LibreSolar/mppt-2420-hpx/(threads)

Thread 1 (2020-02-26):

DAC2 not existing in STM32G431, change pin wiring

martinjaeger, 2020-02-26:
The STM32G431 only has DAC1 with two external channels, so the current DAC2 on PA6 needs to be connected to DAC1_OUT2 at PA5.

Thread 2 (2020-02-26):

Route USB power supply to SMPS input

martinjaeger, 2020-02-26:
The board power supply from USB (useful only for testing) via diode D6 should be routed to SMPS input instead of HV+, as Q9 will not let any current pass to the SMPS.

Thread 3 (2021-03-07):

R14 value should be 2.2k

xsider, 2021-03-07:
R14 should be 2.2k instead of 10k.
2.2k is the value expected by the Software.
2.2k should also be used to be save for ADC!
110k/10k -> Highvoltage over 36.3V could damage microcontroller.

martinjaeger, 2021-03-07:
Oops, yes, definitely. Thanks for posting.

Looks like I have already fixed this during transition to the MPPT 2420 HC variant. You might want to compare with that schematic in case of any doubts.

Also the internal power supply source switching circuitry in this board (page 3) didn't work properly and has been reworked. If power supply from battery side only is sufficient for you, I would just remove the high-side part around Q9 completely.

xsider, 2021-03-07:
> Also the internal power supply source switching circuitry in this board (page 3) didn't work properly and has been reworked. If power supply from battery side only is sufficient for you, I would just remove the high-side part around Q9 completely.

That's a good hint. The main cause to build the HPX was the bootstrap-capability from solar power only, which is missing in PWM_2420_LUS. I will consider to adapt the HC circuit for that, or add just a diode from solar panel, because open circuit solar voltage is below 50V.

martinjaeger, 2021-03-07:
Yeah, it's really useful if you have lithium ion batteries. But that circuit was also quite tricky. The reality was different than theoretical considerations again... the circuit in the develop branch of the HC (v0.2) is finally working as it should :)

But if your voltage is below 50V, a diode should be perfectly fine.
