LibreSolar/mppt-2420-hpx/mppt-2420-hpx.pdf

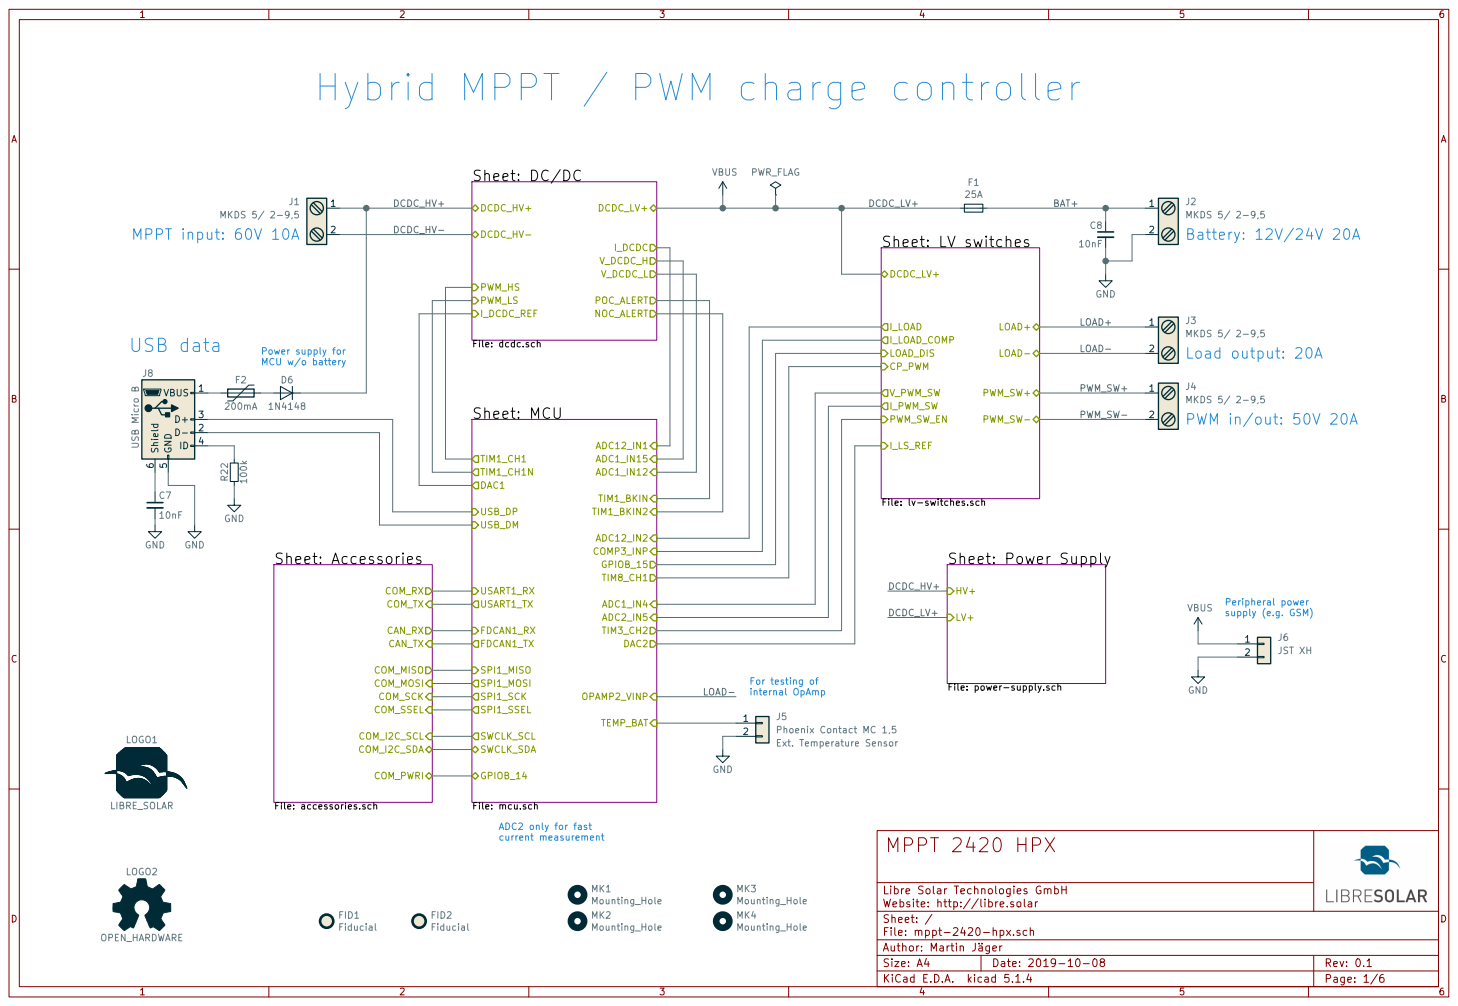
[picture p3: page 1]

Hybrid MPPT / PWM charge controller

LV+ HV+ Sheet: DC/DC

File: lv-switches.sch

File: power-supply.sch

J5Phoenix Contact MC 1,5 Ext. Temperature Sensor

ADC2 only for fast current measurement

File: mppt-2420-hpx.sch Sheet: / Libre Solar Technologies GmbH
Website: http://libre.solar

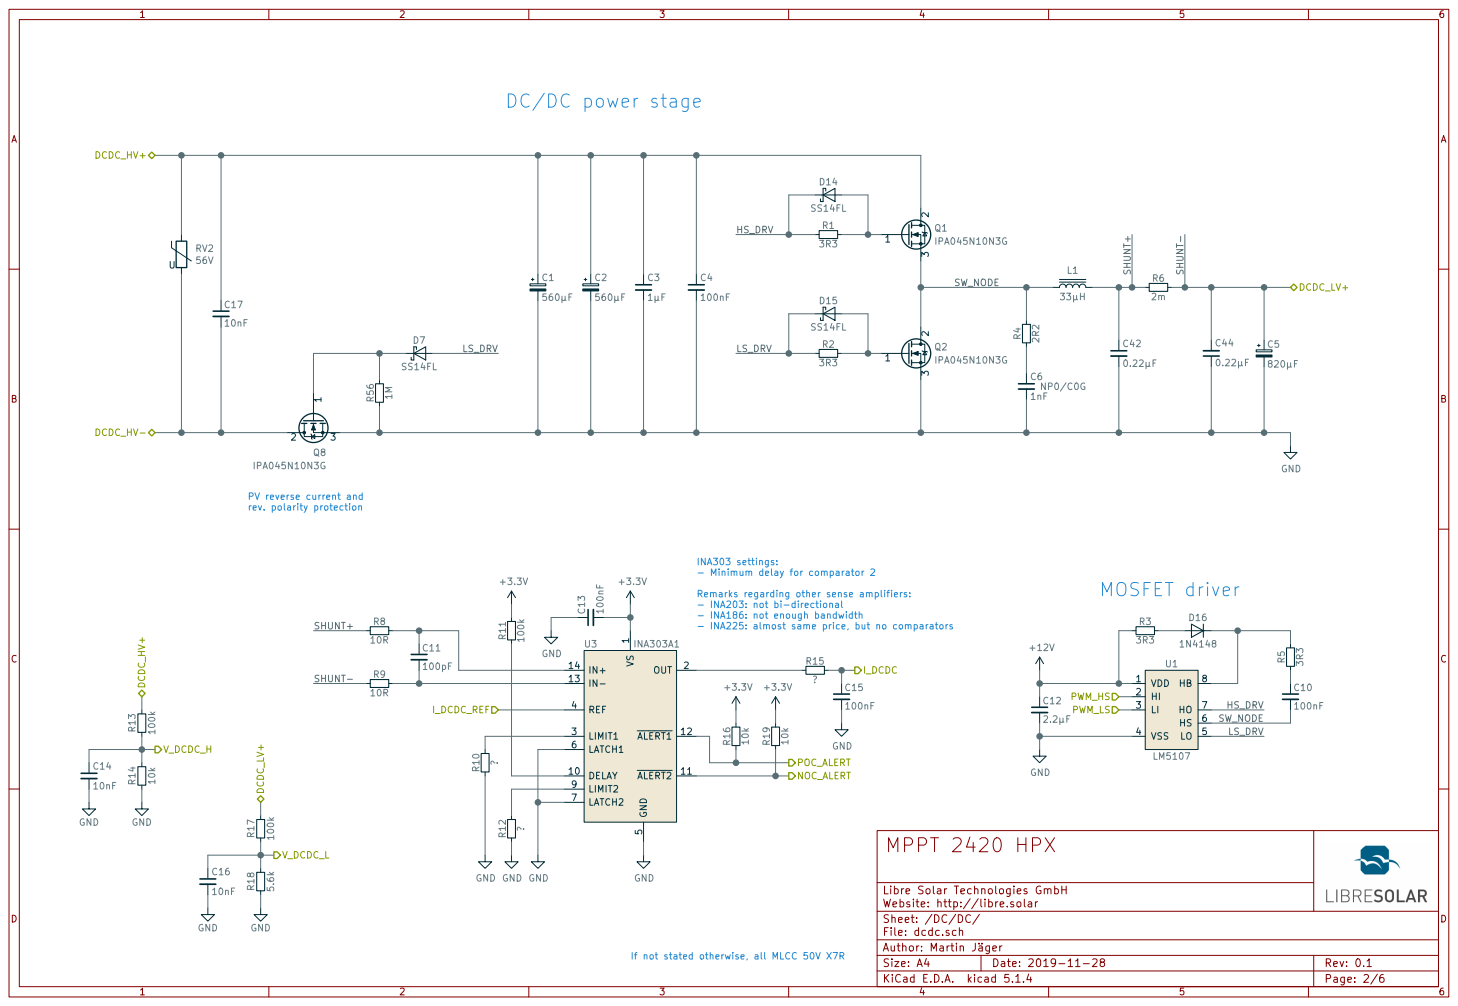
[picture p4: page 2]

DC/DC power stage

INA303 settings:
- Minimum delay for comparator 2

Remarks regarding other sense amplifiers: - INA203: not bi-directional - INA186: not enough bandwidth

- INA225: almost same price, but no comparators

File: dcdc.sch Sheet: /DC/DC/ Libre Solar Technologies GmbH
Website: http://libre.solar

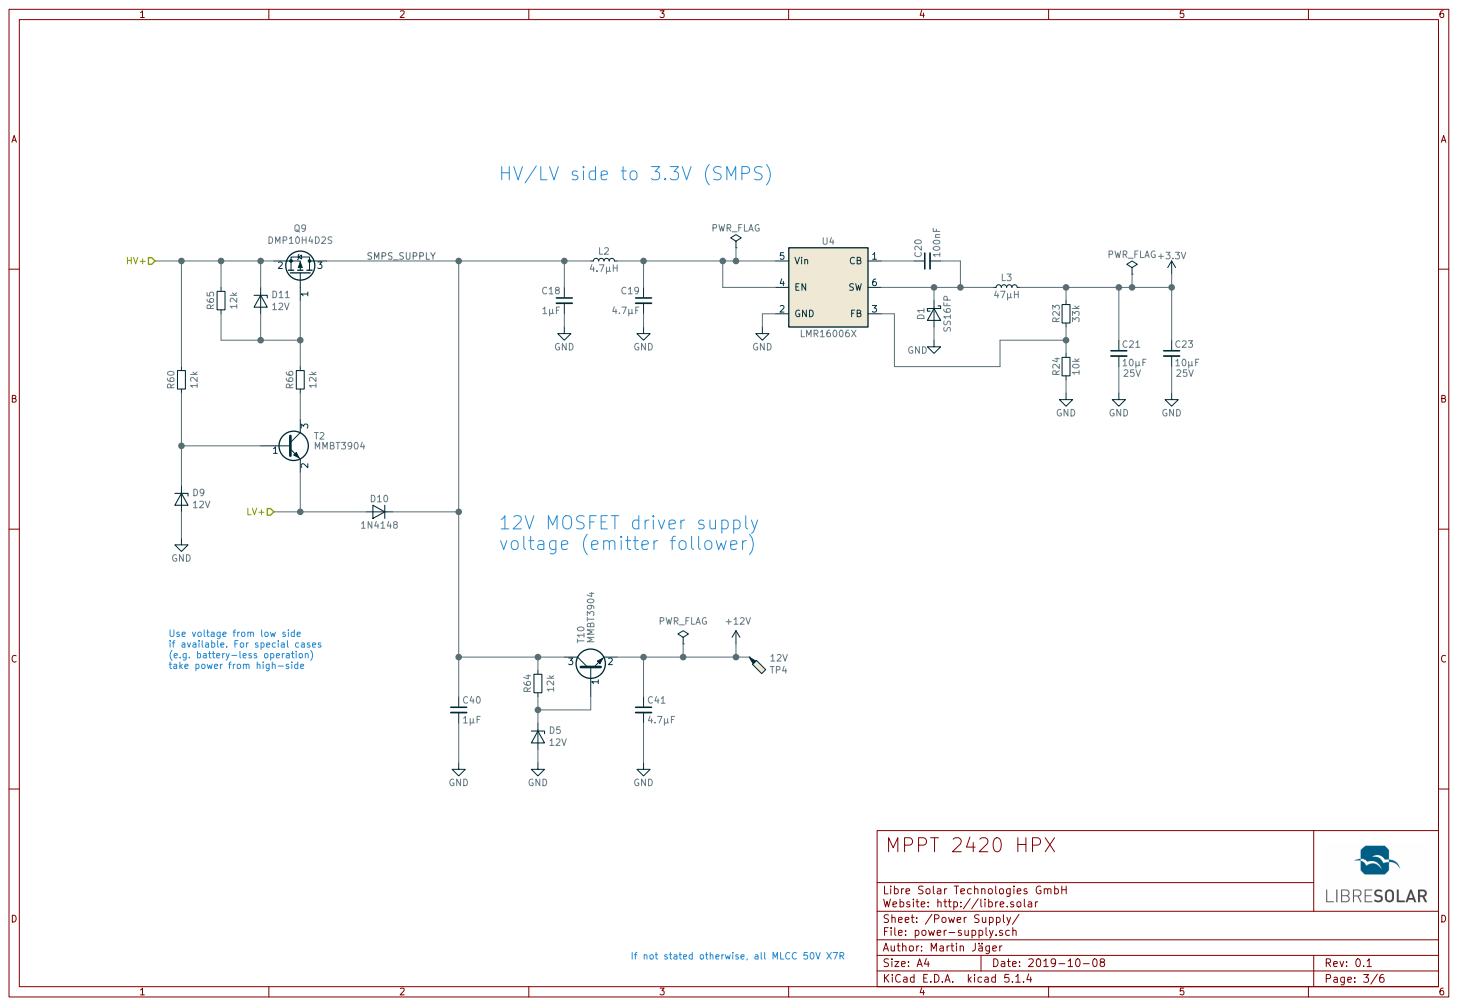
[picture p5: page 3]

HV/LV side to 3.3V (SMPS)

Use voltage from low side
if available. For special cases
(e.g. battery-less operation)
take power from high-side

Website: http://libre.solar GND

Libre Solar Technologies GmbH

Sheet: /Power Supply/
File: power-supply.sch
Author: Martin Jäger

If not stated otherwise, all MLCC 50V X7R

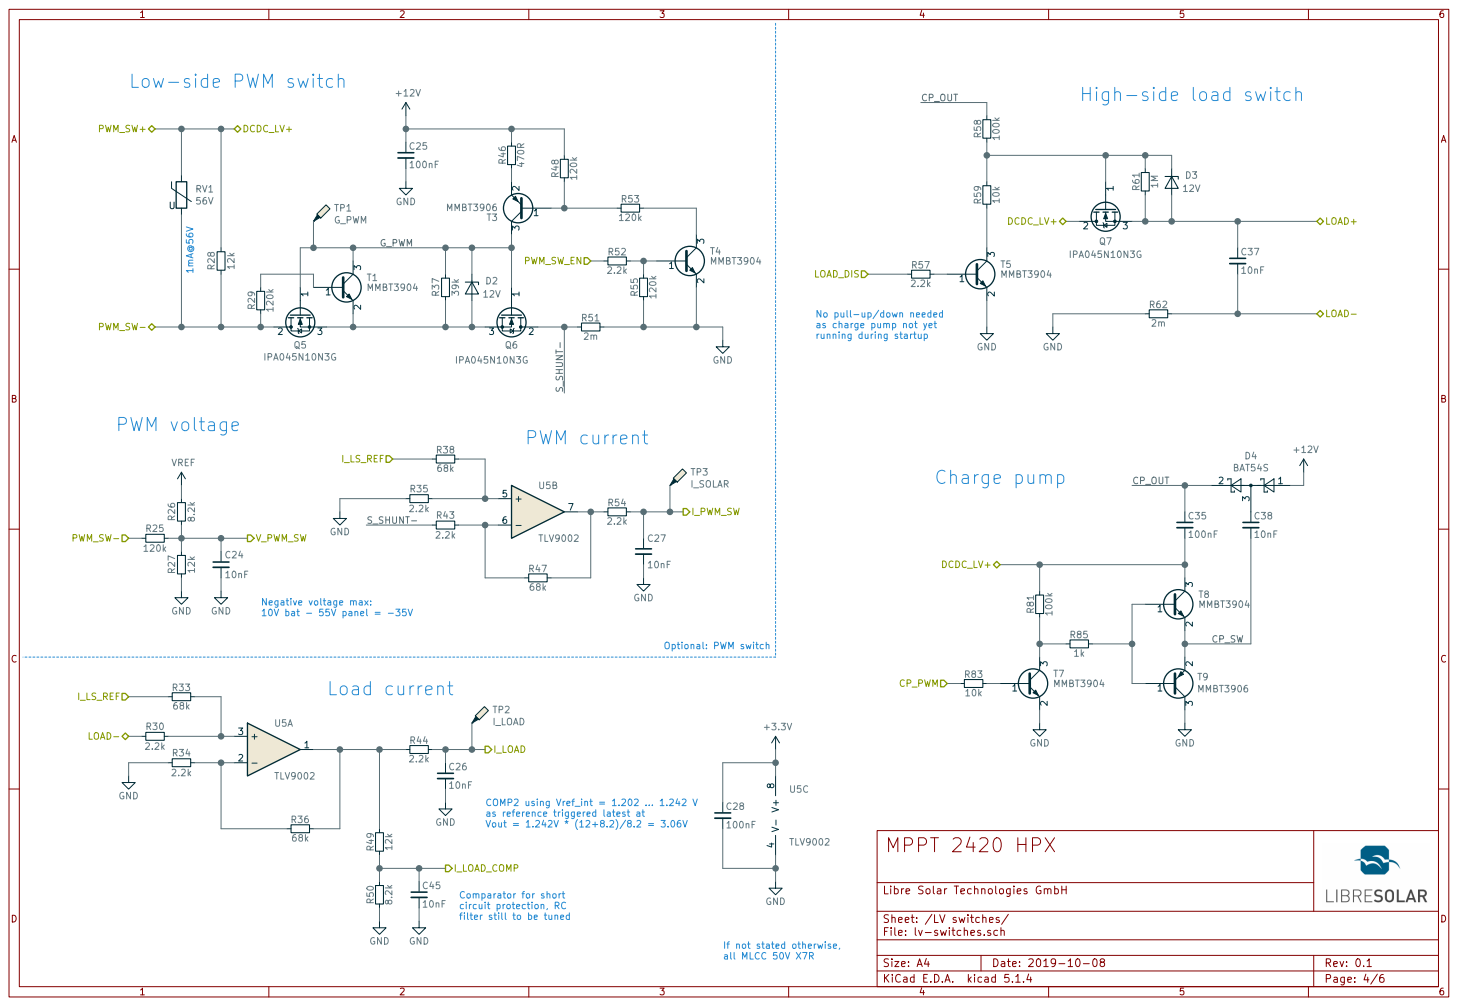
[picture p6: page 4]

Low-side PWM switch

No pull-up/down needed
as charge pump not yet
running during startup

PWM current PWM voltage

filter still to be tuned Negative voltage max:
10V bat - 55V panel = -35V

COMP2 using Vref_int = 1.202 ... 1.242 V
as reference triggered latest at
Vout = 1.242V * (12+8.2)/8.2 = 3.06V

File: lv-switches.sch Sheet: /LV switches/ Libre Solar Technologies GmbH

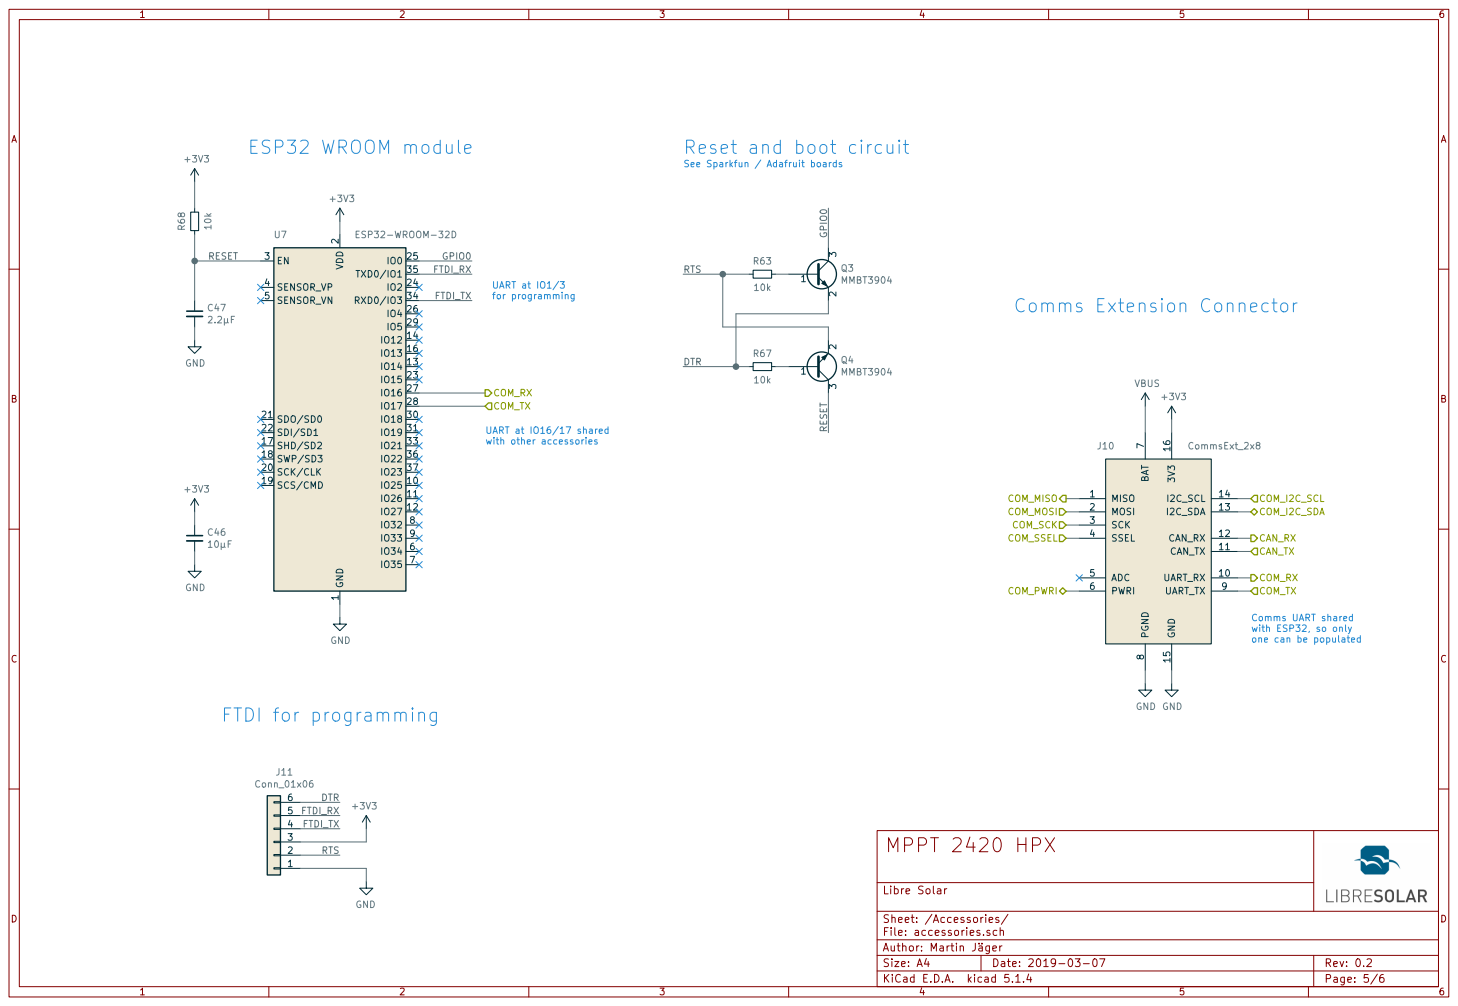
[picture p7: page 5]

See Sparkfun / Adafruit boards UART at IO1/3

2 SCK/CLK 20 SDO/SD0 21 SDI/SD1 22

for programming UART at IO16/17 shared with other accessories

Comms UART shared with ESP32, so only

File: accessories.sch Sheet: /Accessories/ Libre Solar Author: Martin Jäger GND

one can be populated

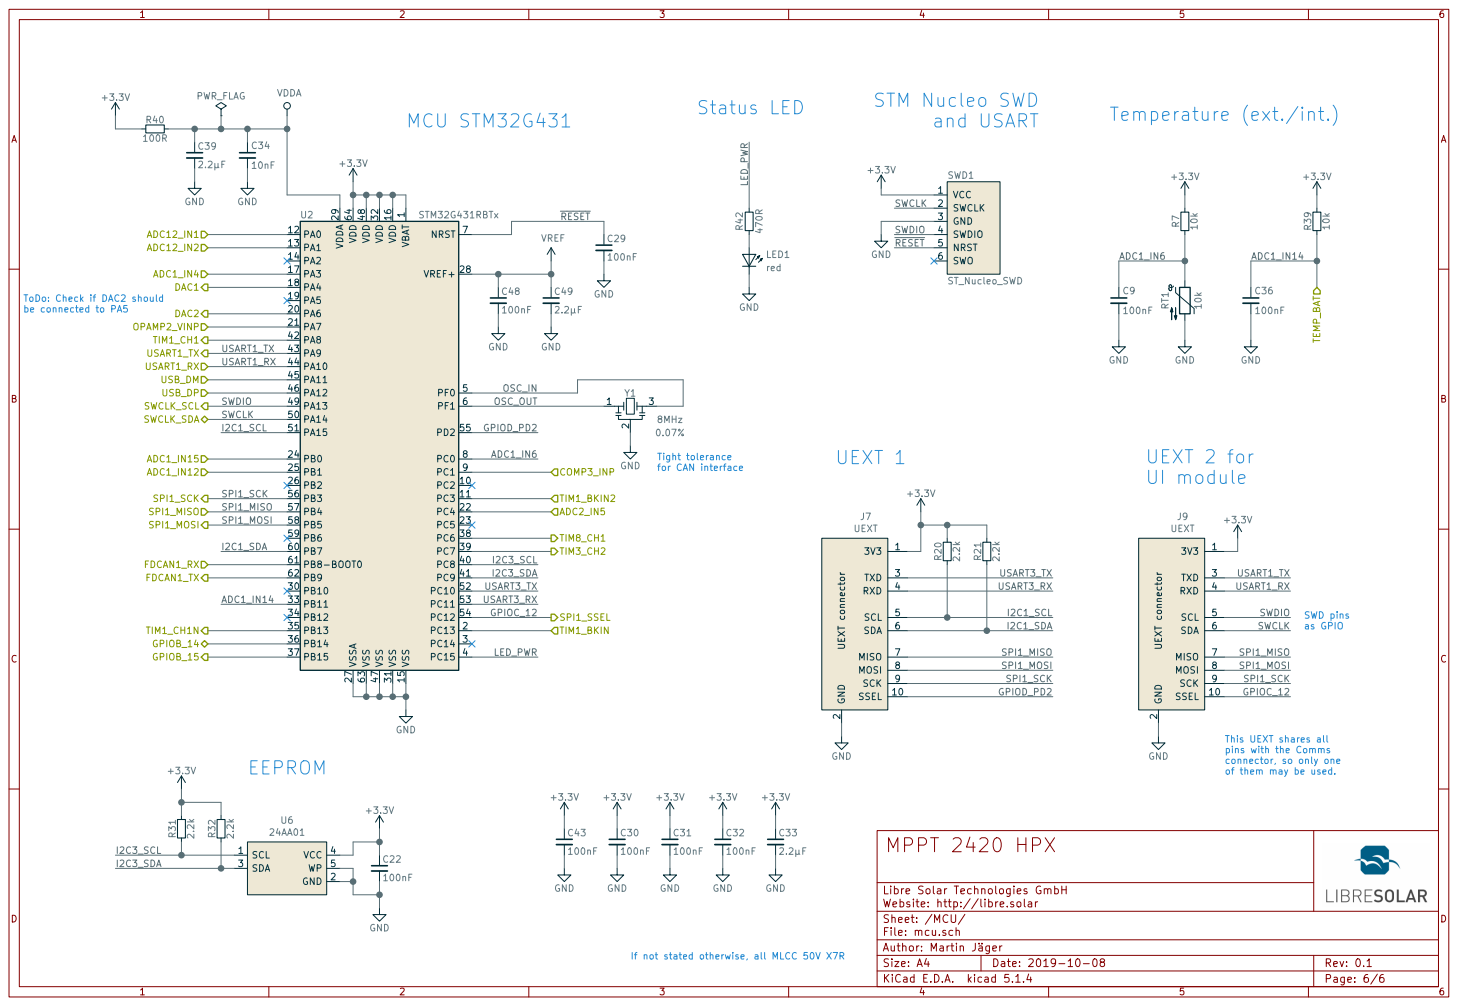
[picture p8: page 6]

1 PC2 10 PC3 11 PA0 12 PA1 13 PA2 14 VSS 15 VDD 16 PA3 17 PA4 18 PA5 19 PC13 2 PA6 20 PA7 21 PC4 22 PC5 23 PB0 24 PB1 25 PB2 26 VSSA 27 VREF+ 28 VDDA 29 PC14 3 PB10 30 VSS 31 VDD 32 PB11 33 PB12 34 PB13 35 PB14 36 PB15 37 PC6 38 PC7 39 PC15 4 PC8 40 PC9 41 PA8 42 PA9 43 PA10 44 PA11 45 PA12 46 VSS 47 VDD 48 PA13 49 PF0 5 PA14 50 PA15 51 PC10 52 PC11 53 PC12 54 PD2 55 PB3 56 PB4 57 PB5 58 PB6 59 PF1 6 PB7 60 PB8-BOOT0 61 PB9 62 VSS 63 VDD 64 NRST 7 PC0 8 PC1 9 U2 STM32G431RBTx C43

ToDo: Check if DAC2 should

for CAN interface EEPROM

2 TXD 3 SCL 5 SDA 6 MISO 7 MOSI 8 SCK 9

SWD pins as GPIO

This UEXT shares all pins with the Comms

connector, so only one
of them may be used.

File: mcu.sch Sheet: /MCU/ Libre Solar Technologies GmbH

If not stated otherwise, all MLCC 50V X7R
