LibreSolar/mppt-2420-hpx/kicad/mppt-2420-hpx.kicad_pcb

## KiCad design kicad/mppt-2420-hpx.kicad_pcb (2019-12-16)

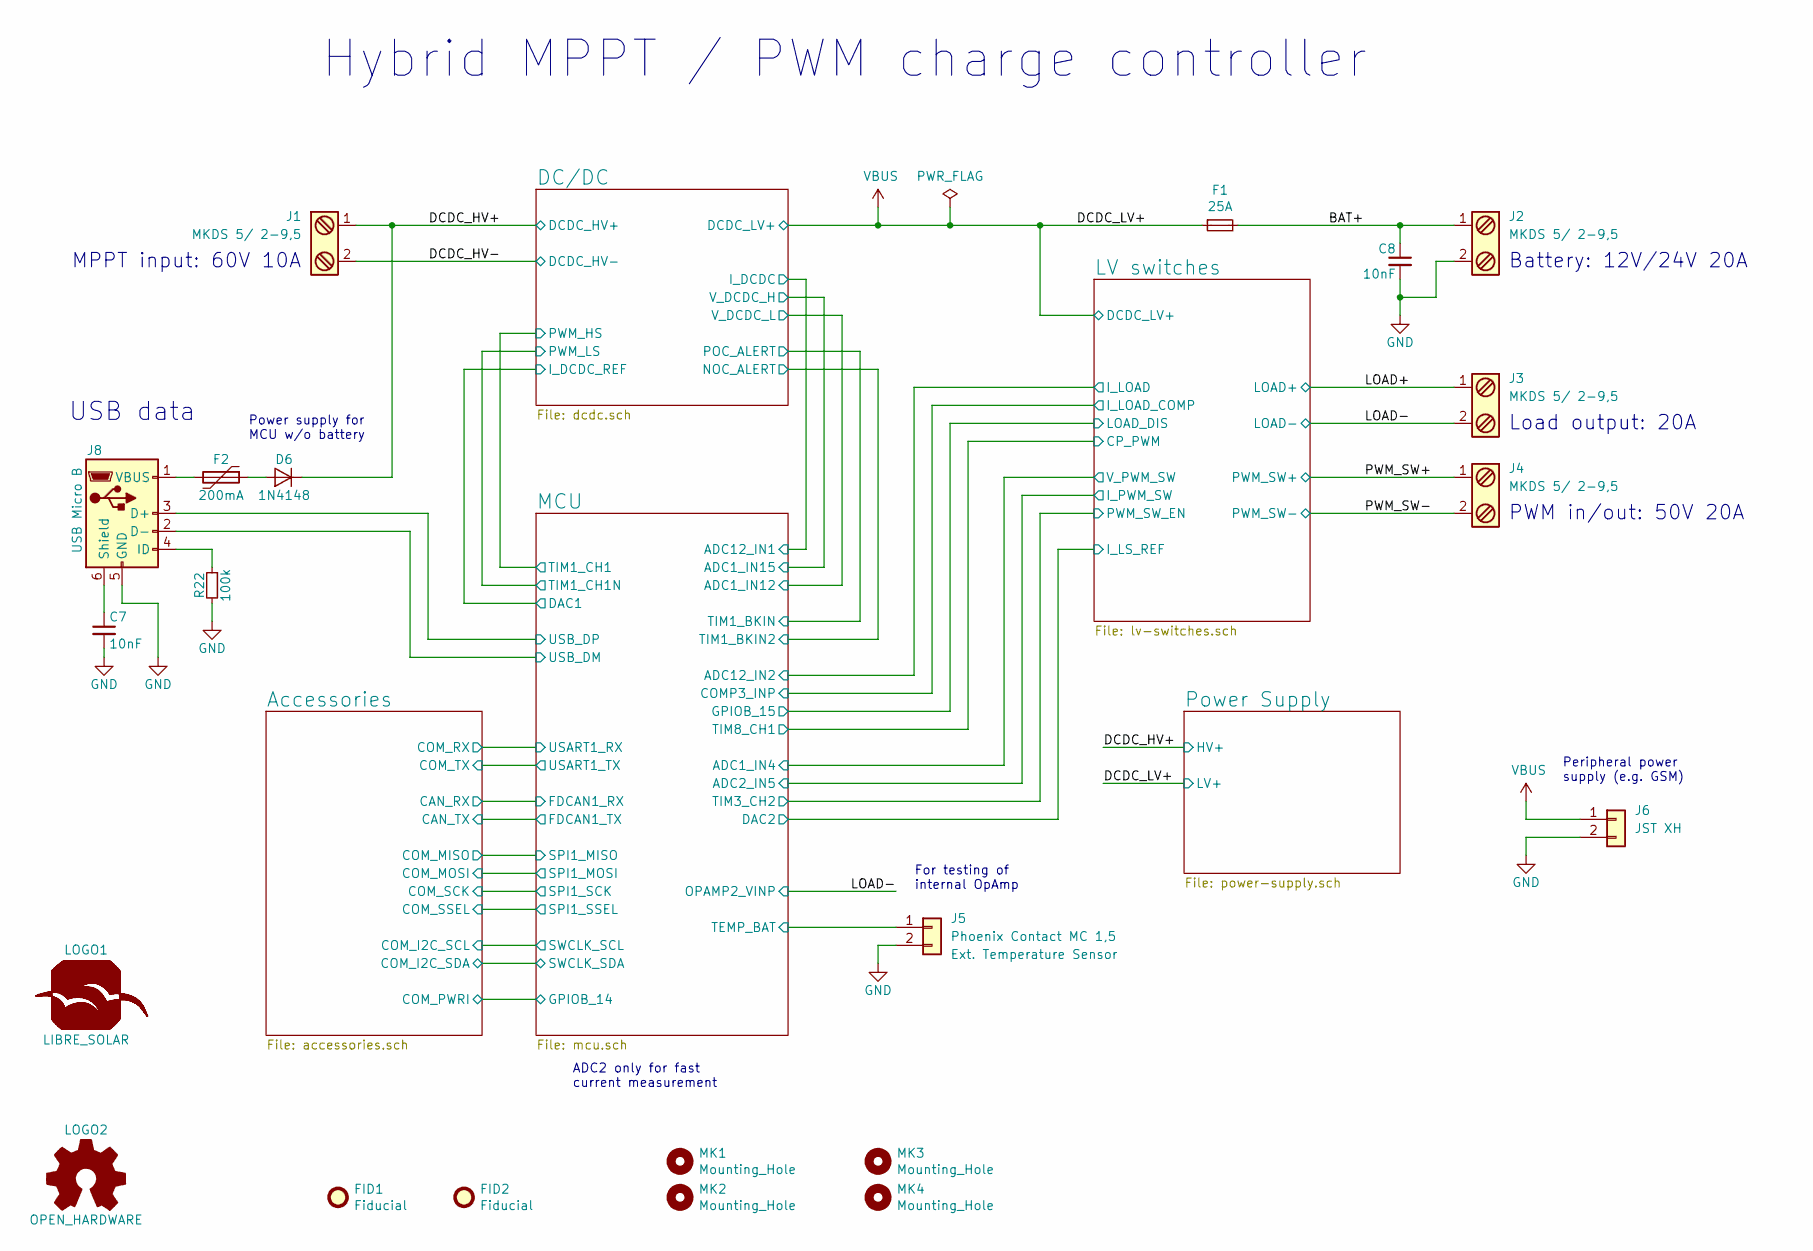
[picture p9: schematic mppt-2420-hpx.sch, MPPT 2420 HPX]

Parts:
C7: 10nF; C_0603_1608
C8: 10nF; C_0603_1608; PartNumber GCM188R72A103KA37D
D6: 1N4148; D_SOD-123; PartNumber 1N4148W-7-F
F1: 25A; Keystone-Fuse-3557-2
F2: 200mA; R_1206_3216; PartNumber 0ZCJ0020FF2E
FID1, FID2: Fiducial; Fiducial_0.7mm
J1, J2, J3, J4: MKDS 5/ 2-9,5; Phoenix_Contact_MKDS_5-2-9,5
J5: Phoenix Contact MC 1,5; Phoenix_Contact_MC_1,5_2-G-3,81
J6: JST XH; JST_XH_B2B-XH-A_1x02_P2.50mm_Vertical; PartNumber B2B-XH-A(LF)(SN)
J8: USB Micro B; USB_Micro-B_10103594-0001LF; PartNumber 10103594-0001LF
LOGO1: LIBRE_SOLAR; LIBRESOLAR_LOGO
LOGO2: OPEN_HARDWARE; OSHW-Logo_5.7x6mm_SilkScreen
MK1, MK2, MK3, MK4: Mounting_Hole; MountingHole_3.2mm_M3
R22: 100k; R_0603_1608; PartNumber RC0603FR-07100KL

Connections:
/BAT+: C8.1, F1.2, J2.1
/DCDC_HV+: D6.1 (K), J1.1; also elsewhere on the board
/DCDC_HV-: J1.2; also elsewhere on the board
/LOAD+: J3.1; also elsewhere on the board
/LOAD-: J3.2; also elsewhere on the board
/MCU/TEMP_BAT: J5.1; also elsewhere on the board
/MCU/USB_DM: J8.2 (D-); also elsewhere on the board
/MCU/USB_DP: J8.3 (D+); also elsewhere on the board
/PWM_SW-: J4.2; also elsewhere on the board
GND: C7.2, C8.2, J2.2, J5.2, J6.2, J8.5 (GND), R22.2; also elsewhere on the board
unnamed: C7.1, J8.6 (Shield)
unnamed: D6.2 (A), F2.1
unnamed: F2.2, J8.1 (VBUS)
unnamed: J8.4 (ID), R22.1
VBUS: F1.1, J4.1, J6.1; also elsewhere on the board

Notes on the sheet:
Hybrid MPPT / PWM charge controller
USB data
Power supply for MCU w/o battery
Peripheral power supply (e.g. GSM)
For testing of internal OpAmp
MPPT input: 60V 10A
Battery: 12V/24V 20A
Load output: 20A
PWM in/out: 50V 20A
ADC2 only for fast current measurement

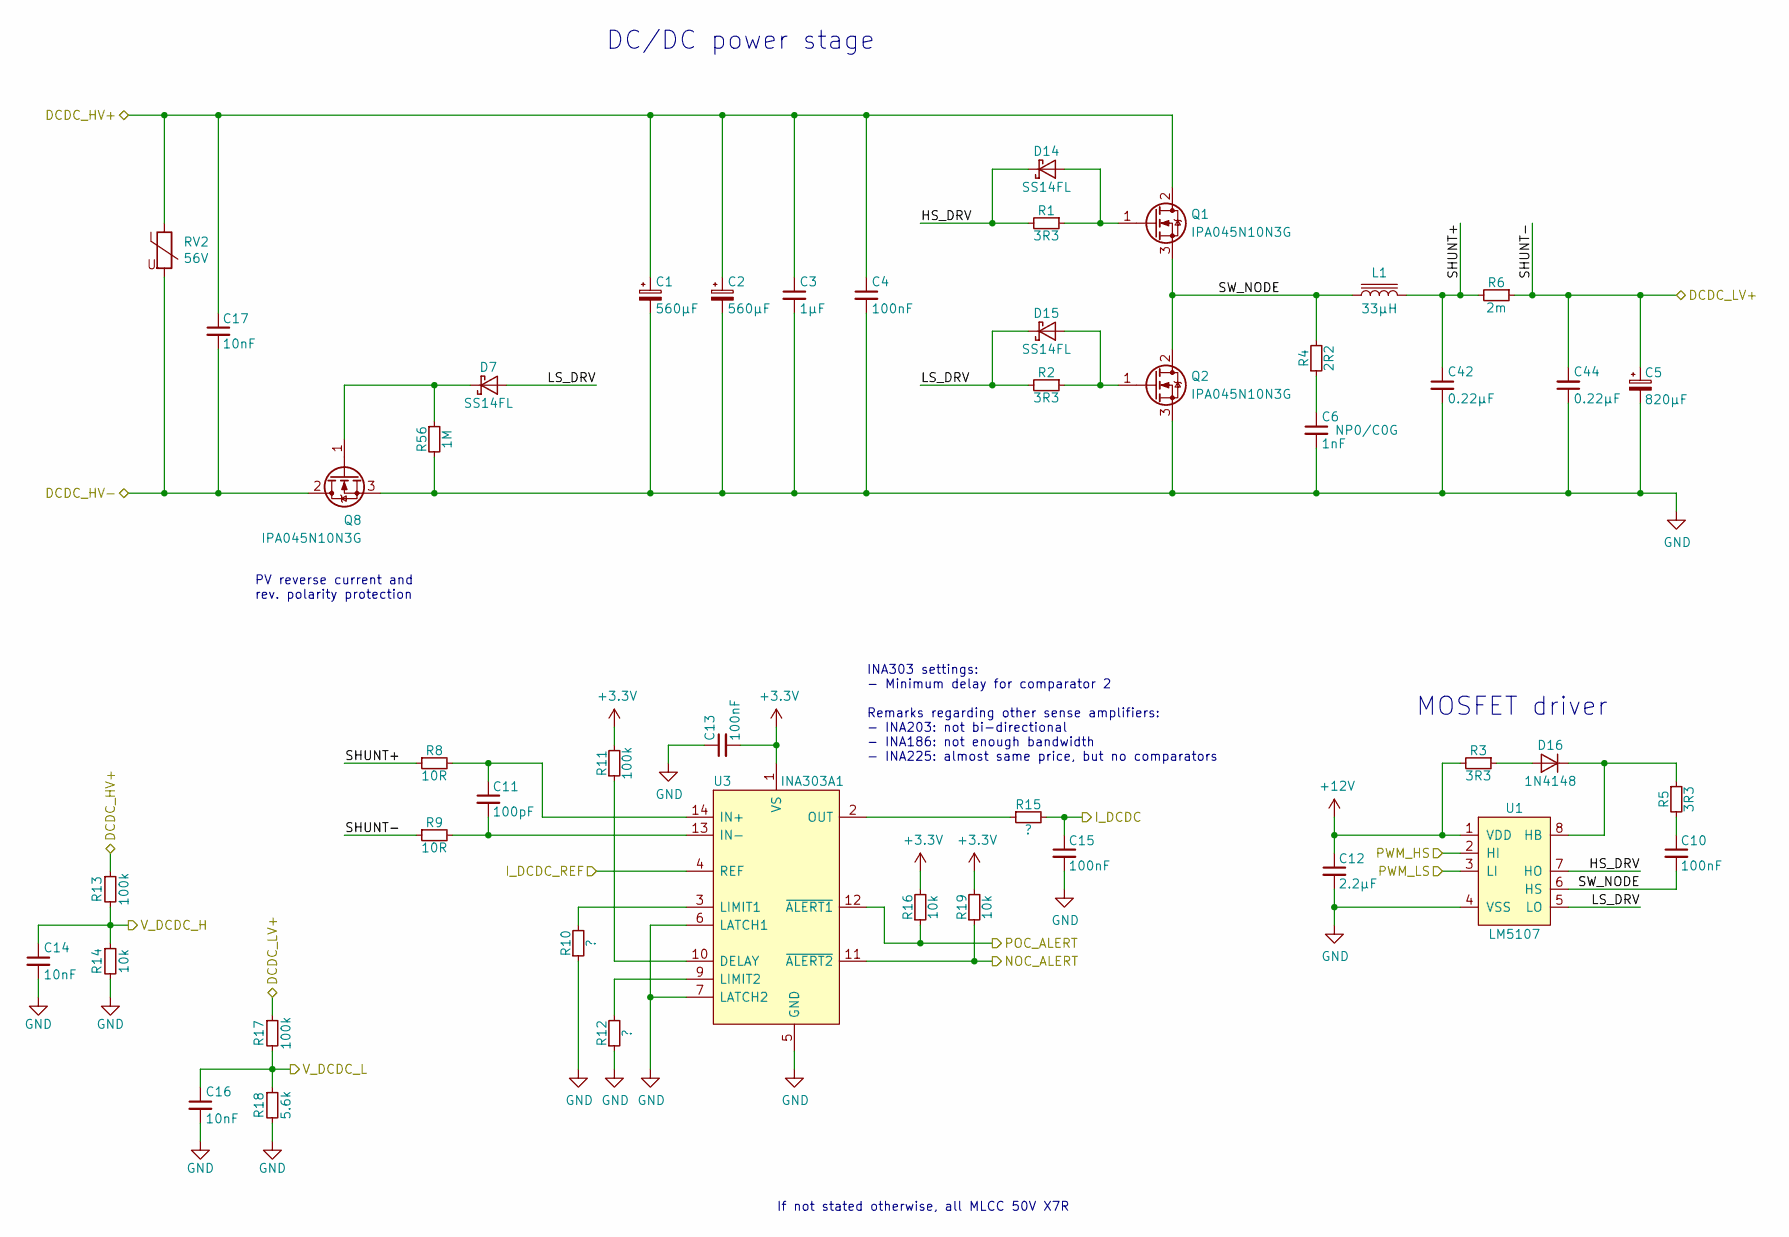
[picture p10: schematic dcdc.sch, MPPT 2420 HPX]

Parts:
C1, C2: 560µF; CP_Radial_D18.0mm_P7.50mm; PartNumber EKZN101ELL561MM25S
C3: 1µF; C_0805_2012; PartNumber GRJ32DC72A475KE11L
C4: 100nF; C_0805_2012
C5: 820µF; CP_Radial_D10.0mm_P5.00mm; PartNumber EEU-FR1V821L
C6: 1nF; C_0603_1608; PartNumber GRM1885C2A102JA01D
C10, C13, C15: 100nF; C_0603_1608; PartNumber GRM188R71H104KA93D
C11: 100pF; C_0603_1608
C12: 2.2µF; C_0603_1608; PartNumber GRM188R61E225KA12D
C14, C16: 10nF; C_0603_1608; PartNumber GRM188R71H103KA01J
C17: 10nF; C_0603_1608; PartNumber GCM188R72A103KA37D
C42, C44: 0.22µF; C_Rect_L7.2mm_W3.5mm_P5.00mm_FKS2_FKP2_MKS2_MKP2; PartNumber 224J63
D7, D14, D15: SS14FL; D_SOD-123; PartNumber SS14FL
D16: 1N4148; D_SOD-123; PartNumber 1N4148W-7-F
L1: 33µH; L-FERYSTER-DTMSS-27; PartNumber DTMSS-27/0,033/20-H
Q1, Q2, Q8: IPA045N10N3G; TO-220-3_Horizontal_BottomHeatsink; PartNumber IPA045N10N3G
R1, R2, R3, R5: 3R3; R_0805_2012; PartNumber RC0805FR-073R3L
R4: 2R2; R_1206_3216; PartNumber RC1206FR-072R2L
R6: 2m; R_Bourns_CRE2512; PartNumber CRE2512-FZ-R002E-3
R8, R9: 10R; R_0603_1608; PartNumber RC0603FR-07100KL
R10, R12, R15: ?; R_0603_1608; PartNumber RC0603FR-07100KL
R11, R13, R17: 100k; R_0603_1608; PartNumber RC0603FR-07100KL
R14, R16, R19: 10k; R_0603_1608; PartNumber RC0603FR-0710KL
R18: 5.6k; R_0603_1608; PartNumber RC0603FR-075K6L
R56: 1M; R_0603_1608; PartNumber RC0603FR-071ML
RV2: 56V; RV_Disc_D12mm_W4.3mm_P7.5mm; PartNumber MOV-10D560K
U1: LM5107; SOIC-8_3.9x4.9mm_Pitch1.27mm; PartNumber LM5107MAX/NOPB
U3: INA303A1; TSSOP-14_4.4x5mm_P0.65mm; PartNumber INA303A1IPWR

Connections:
+12V: C12.1, R3.2, U1.1 (VDD); also elsewhere on the board
/DC/DC/HS_DRV: D14.1 (K), R1.2, U1.7 (HO)
/DC/DC/LS_DRV: D7.2 (A), D15.1 (K), R2.2, U1.5 (LO)
/DC/DC/NOC_ALERT: R19.1, U3.11 (~ALERT2); also elsewhere on the board
/DC/DC/POC_ALERT: R16.1, U3.12 (~ALERT1); also elsewhere on the board
/DC/DC/PWM_HS: U1.2 (HI); also elsewhere on the board
/DC/DC/PWM_LS: U1.3 (LI); also elsewhere on the board
/DC/DC/SHUNT+: C42.1, L1.2, R6.2, R8.1
/DC/DC/SW_NODE: C10.2, L1.1, Q1.3 (S), Q2.2 (D), R4.2, U1.6 (HS)
/DCDC_HV+: C1.1, C2.1, C3.1, C4.1, C17.1, Q1.2 (D), R13.1, RV2.1; also elsewhere on the board
/DCDC_HV-: C17.2, Q8.2 (D), RV2.2; also elsewhere on the board
/MCU/ADC1_IN12: C16.1, R17.2, R18.1; also elsewhere on the board
/MCU/ADC1_IN15: C14.1, R13.2, R14.1; also elsewhere on the board
/MCU/ADC12_IN1: C15.1, R15.2; also elsewhere on the board
/MCU/DAC1: U3.4 (REF); also elsewhere on the board
GND: C1.2, C2.2, C3.2, C4.2, C5.2, C6.2, C12.2, C13.1, C14.2, C15.2, C16.2, C42.2, C44.1, Q2.3 (S), Q8.3 (S), R10.1, R12.1, R14.2, R18.2, R56.2, U1.4 (VSS), U3.5 (GND), U3.6 (LATCH1), U3.7 (LATCH2); also elsewhere on the board
unnamed: C6.1, R4.1
unnamed: C10.1, R5.2
unnamed: C11.1, R8.2, U3.14 (IN+)
unnamed: C11.2, R9.2, U3.13 (IN-)
unnamed: D7.1 (K), Q8.1 (G), R56.1
unnamed: D14.2 (A), Q1.1 (G), R1.1
unnamed: D15.2 (A), Q2.1 (G), R2.1
unnamed: D16.1 (K), R5.1, U1.8 (HB)
unnamed: D16.2 (A), R3.1
unnamed: R10.2, U3.3 (LIMIT1)
unnamed: R11.1, U3.10 (DELAY)
unnamed: R12.2, U3.9 (LIMIT2)
unnamed: R15.1, U3.2 (OUT)
VBUS: C5.1, C44.2, R6.1, R9.1, R17.1; also elsewhere on the board

Notes on the sheet:
DC/DC power stage
MOSFET driver
If not stated otherwise, all MLCC 50V X7R
INA303 settings: - Minimum delay for comparator 2 Remarks regarding other sense amplifiers: - INA203: not bi-directional - INA186: not enough bandwidth - INA225: almost same price, but no comparators
PV reverse current and rev. polarity protection

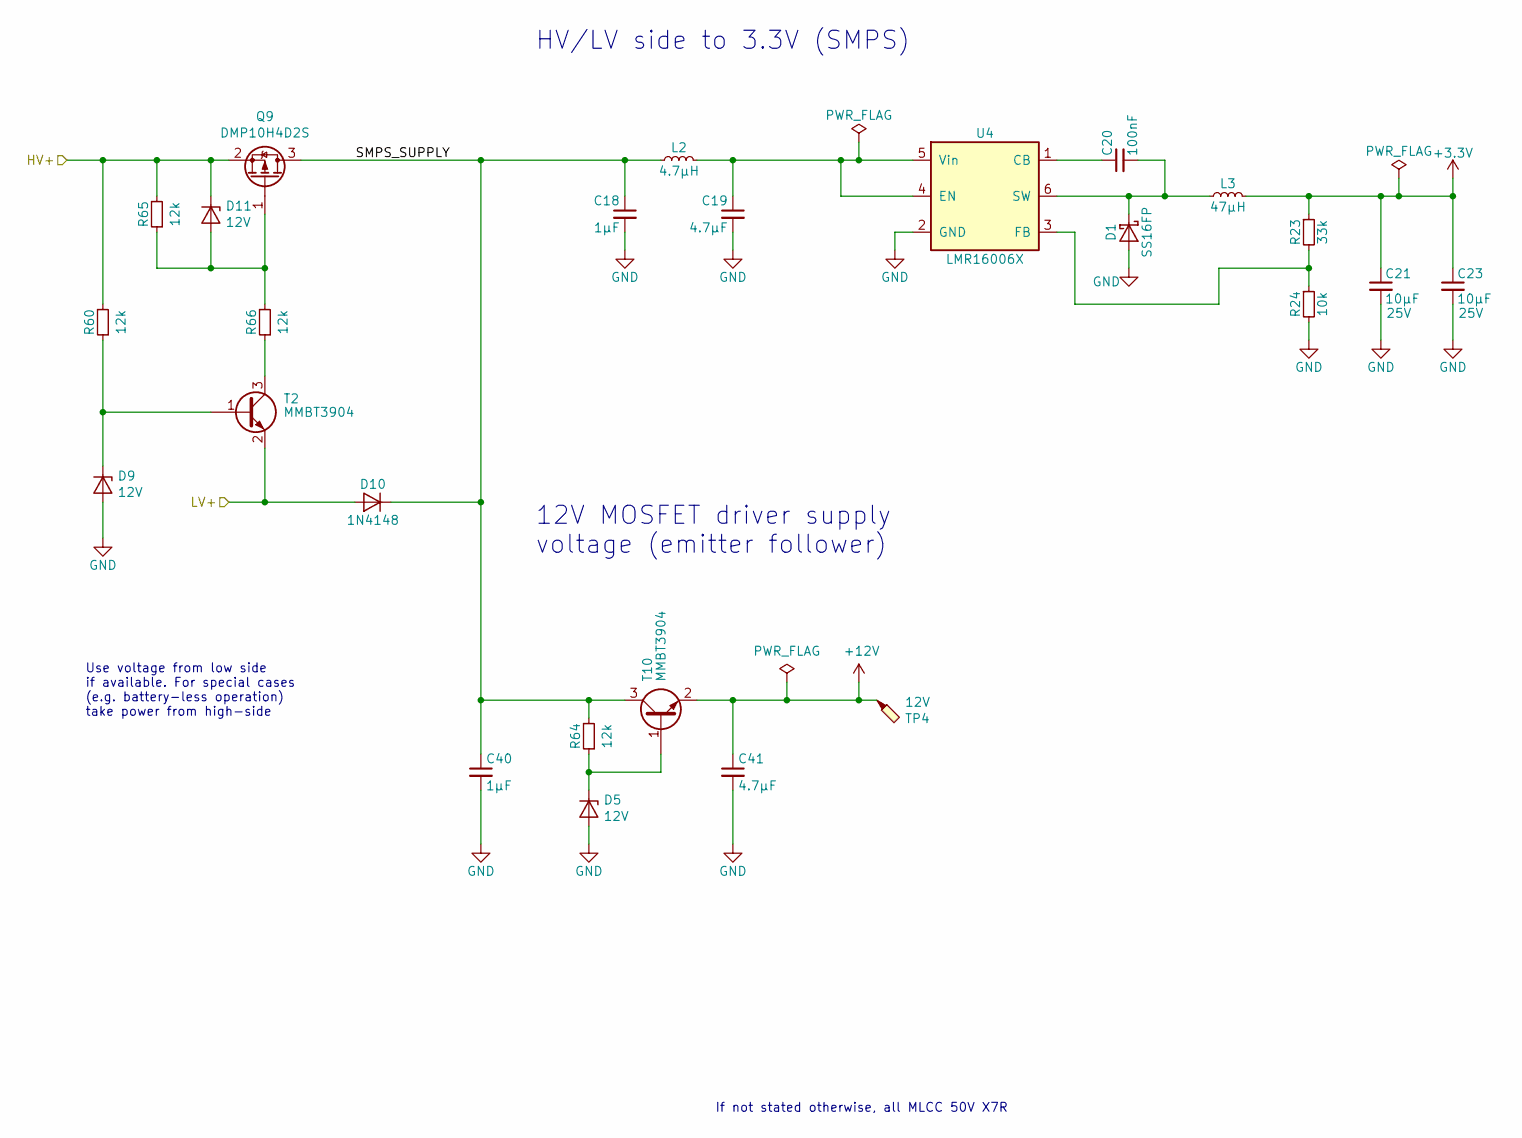
[picture p11: schematic power-supply.sch, MPPT 2420 HPX]

Parts:
C18: 1µF; C_0805_2012; PartNumber GRJ21BC72A105KE11L
C19: 4.7µF; C_1210_3225; PartNumber GRJ32DC72A475KE11L
C20: 100nF; C_0603_1608; PartNumber GRM188R71H104KA93D
C21, C23: 10µF; C_0805_2012; PartNumber GRM21BR61E106KA73L
C40: 1µF; C_0603_1608; PartNumber CC0805KKX7R9BB105
C41: 4.7µF; C_0603_1608; PartNumber 885012107018
D1: SS16FP; D_PowerDI-123; PartNumber SS16FP
D5, D9, D11: 12V; D_SOT-23_ANK; PartNumber SZBZX84C12LT3G
D10: 1N4148; D_SOD-123; PartNumber 1N4148W-7-F
L2: 4.7µH; L_0805_2012Metric; PartNumber LQM21PN4R7NGRD
L3: 47µH; Bourns_SRN6045TA; PartNumber NR6045T470M
Q9: DMP10H4D2S; SOT-23; PartNumber DMP10H4D2S-7
R23: 33k; R_0603_1608; PartNumber RC0603FR-0733KL
R24: 10k; R_0603_1608; PartNumber RC0603FR-0710KL
R60, R64, R65, R66: 12k; R_0603_1608; PartNumber RC0805FR-0712KL
T2, T10: MMBT3904; SOT-23; PartNumber MMBT3904-7-F
TP4: 12V; TestPoint_Pad_D1.0mm
U4: LMR16006X; SOT-23-6; PartNumber LMR16006XDDCR

Connections:
+12V: C41.1, T10.2 (E), TP4.1; also elsewhere on the board
/DCDC_HV+: D11.1 (K), Q9.2 (S), R60.2, R65.2; also elsewhere on the board
/Power Supply/SMPS_SUPPLY: C18.1, C40.1, D10.1 (K), L2.1, Q9.3 (D), R64.2, T10.3 (C)
GND: C18.2, C19.2, C21.2, C23.2, C40.2, C41.2, D1.2 (A), D5.2 (A), D9.2 (A), R24.2, U4.2 (GND); also elsewhere on the board
unnamed: C19.1, L2.2, U4.4 (EN), U4.5 (Vin)
unnamed: C20.1, U4.1 (CB)
unnamed: C20.2, D1.1 (K), L3.1, U4.6 (SW)
unnamed: D5.1 (K), R64.1, T10.1 (B)
unnamed: D9.1 (K), R60.1, T2.1 (B)
unnamed: D11.2 (A), Q9.1 (G), R65.1, R66.2
unnamed: R23.2, R24.1, U4.3 (FB)
unnamed: R66.1, T2.3 (C)
VBUS: D10.2 (A), T2.2 (E); also elsewhere on the board

Notes on the sheet:
HV/LV side to 3.3V (SMPS)
If not stated otherwise, all MLCC 50V X7R
12V MOSFET driver supply voltage (emitter follower)
Use voltage from low side if available. For special cases (e.g. battery-less operation) take power from high-side

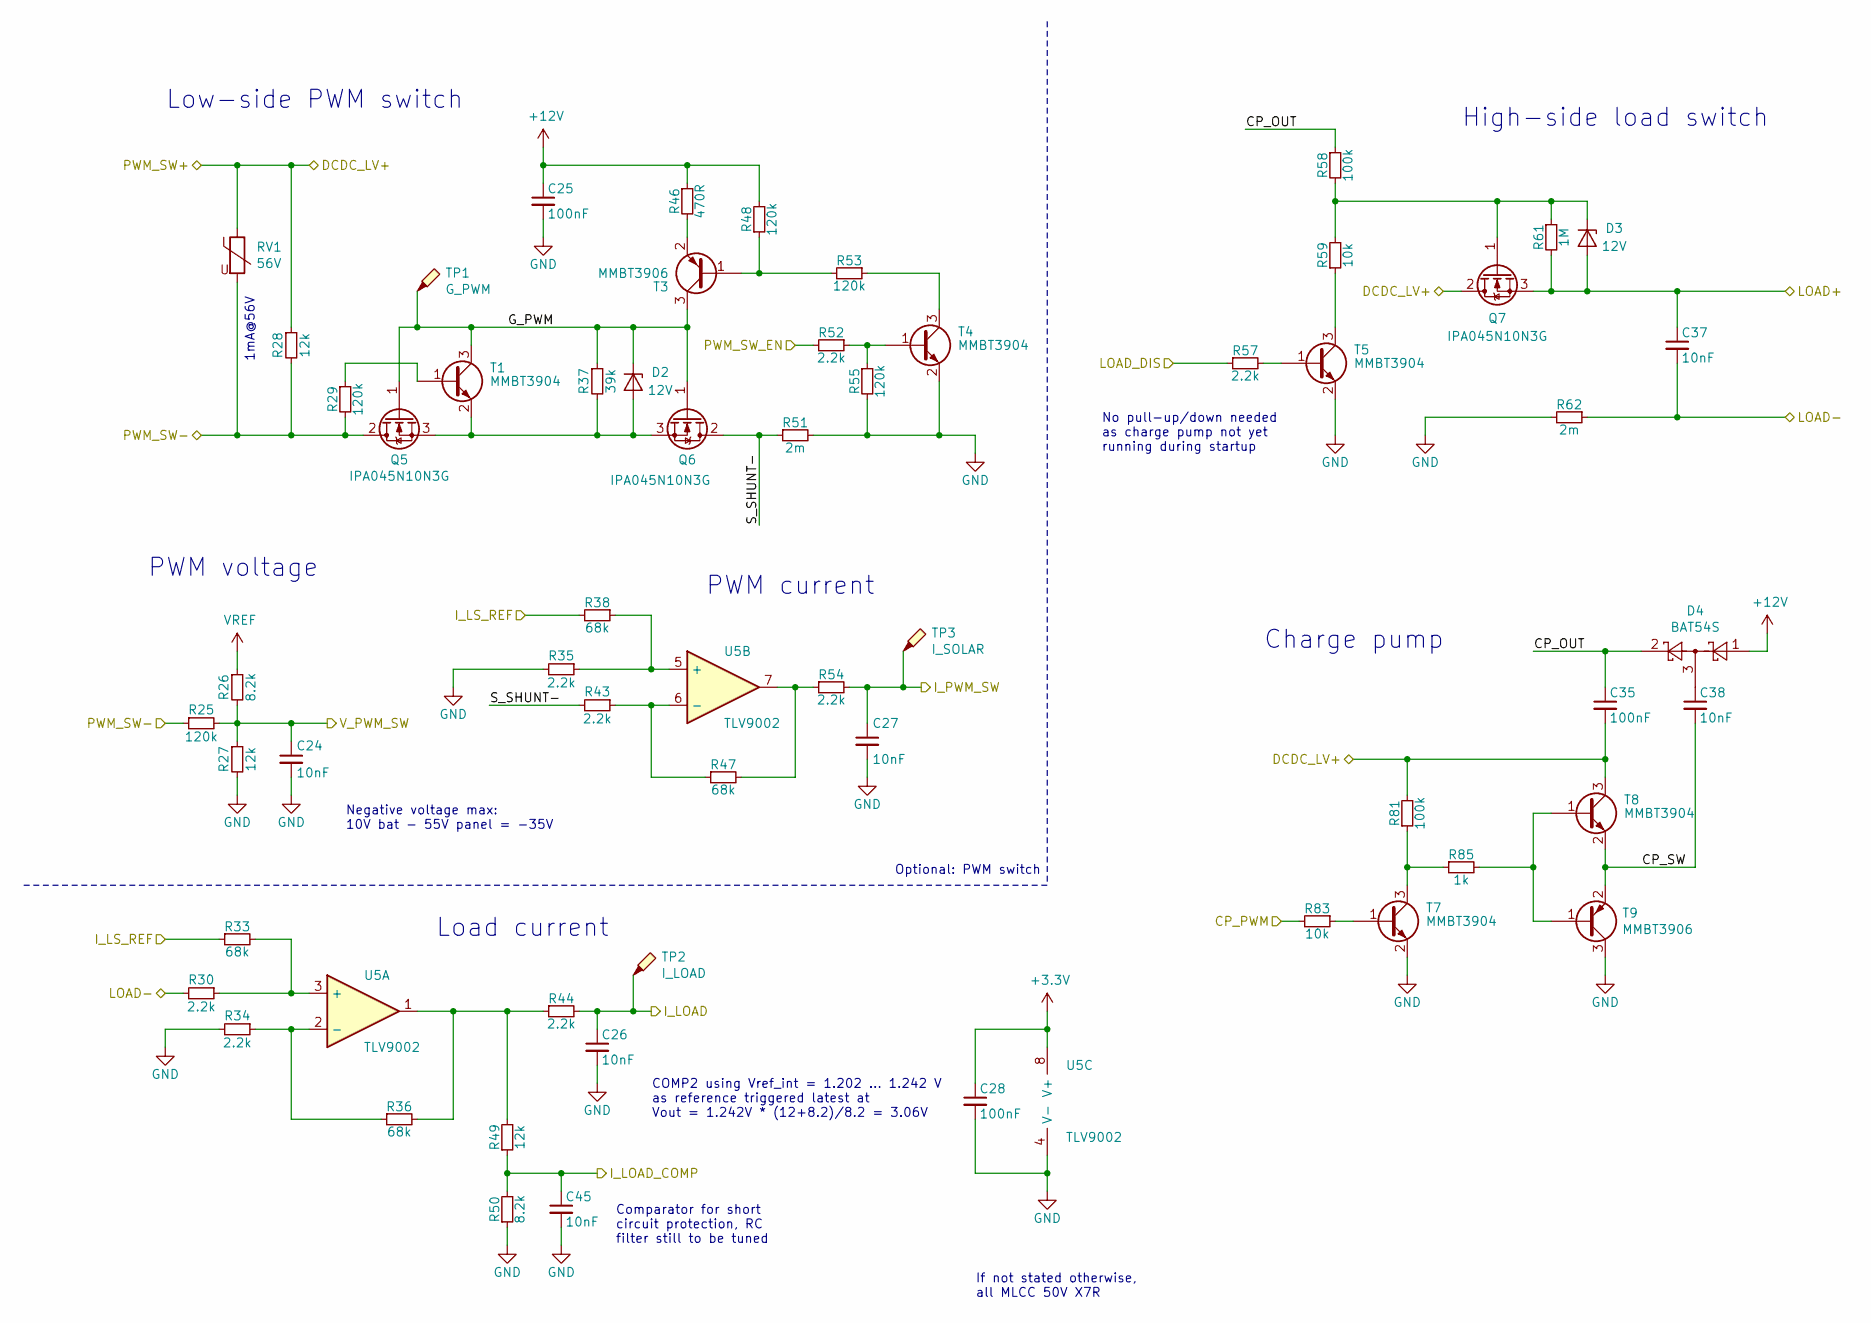
[picture p12: schematic lv-switches.sch, MPPT 2420 HPX]

Parts:
C24, C26, C27, C45: 10nF; C_0603_1608; PartNumber CC0805KRX7R0BB103
C25, C28: 100nF; C_0603_1608; PartNumber CC0805KRX7R9BB104
C35: 100nF; C_0603_1608
C37: 10nF; C_0603_1608; PartNumber GCM188R72A103KA37D
C38: 10nF; C_0603_1608
D2, D3: 12V; D_SOT-23_ANK; PartNumber SZBZX84C12LT3G
D4: BAT54S; SOT-23; PartNumber BAT54SLT1G
Q5, Q6, Q7: IPA045N10N3G; TO-220-3_Horizontal_BottomHeatsink; PartNumber IPA045N10N3G
R25, R29, R48, R53, R55: 120k; C_0603_1608; PartNumber RC0805FR-07120KL
R26, R50: 8.2k; C_0603_1608; PartNumber RC0805FR-078K2L
R27, R49: 12k; C_0603_1608; PartNumber RC0805FR-0712KL
R28: 12k; R_0603_1608; PartNumber RC0805FR-0712KL
R30, R34, R35, R43, R52, R54: 2.2k; R_0603_1608; PartNumber RC0805FR-072K2L
R33, R36, R38, R47: 68k; C_0603_1608; PartNumber RC0805FR-0768KL
R37: 39k; R_0603_1608; PartNumber RC0805FR-0739KL
R44: 2.2k; C_0603_1608; PartNumber RC0805FR-072K2L
R46: 470R; R_0603_1608; PartNumber RC0805FR-07470RL
R51, R62: 2m; R_Bourns_CRE2512; PartNumber CRE2512-FZ-R002E-3
R57: 2.2k; R_0603_1608; PartNumber RC0603FR-0710KL
R58: 100k; R_0603_1608
R59: 10k; R_0603_1608; PartNumber RC0603FR-0756KL
R61: 1M; R_0603_1608; PartNumber RC0603FR-071ML
R81: 100k; R_0603_1608; PartNumber RC0603FR-07100KL
R83: 10k; R_0603_1608; PartNumber RC0603FR-0710KL
R85: 1k; R_0603_1608; PartNumber RC0603FR-071KL
RV1: 56V; RV_Disc_D12mm_W4.3mm_P7.5mm; PartNumber MOV-10D560K
T1, T4, T5, T7, T8: MMBT3904; SOT-23; PartNumber MMBT3904-7-F
T3: MMBT3906; SOT-23; PartNumber MMBT3906-7-F
T9: MMBT3906; SOT-23
TP1: G_PWM; TestPoint_Pad_D1.0mm
TP2: I_LOAD; TestPoint_Pad_D1.0mm
TP3: I_SOLAR; TestPoint_Pad_D1.0mm
U5: TLV9002; SOIC-8_3.9x4.9mm_Pitch1.27mm; PartNumber LM258DR

Connections:
+12V: C25.1, D4.1, R46.1, R48.2; also elsewhere on the board
/LOAD+: C37.1, D3.2 (A), Q7.3 (S), R61.2; also elsewhere on the board
/LOAD-: C37.2, R30.2, R62.1; also elsewhere on the board
/LV switches/CP_OUT: C35.1, D4.2, R58.1
/LV switches/CP_PWM: R83.2; also elsewhere on the board
/LV switches/CP_SW: C38.2, T8.2 (E), T9.2 (E)
/LV switches/G_PWM: D2.1 (K), Q5.1 (G), Q6.1 (G), R37.1, T1.3 (C), T3.3 (C), TP1.1
/LV switches/PWM_SW_EN: R52.2; also elsewhere on the board
/LV switches/S_SHUNT-: Q6.2 (D), R43.2, R51.1
/MCU/ADC1_IN4: C24.1, R25.2, R26.2, R27.1; also elsewhere on the board
/MCU/ADC2_IN5: C27.1, R54.2, TP3.1; also elsewhere on the board
/MCU/ADC12_IN2: C26.1, R44.2, TP2.1; also elsewhere on the board
/MCU/COMP3_INP: C45.1, R49.1, R50.2; also elsewhere on the board
/MCU/DAC2: R33.1, R38.2; also elsewhere on the board
/MCU/GPIOB_15: R57.1; also elsewhere on the board
/PWM_SW-: Q5.2 (D), R25.1, R28.2, R29.2, RV1.2; also elsewhere on the board
GND: C24.2, C25.2, C26.2, C27.2, C28.2, C45.2, R27.2, R34.2, R35.2, R50.1, R51.2, R55.2, R62.2, T4.2 (E), T5.2 (E), T7.2 (E), T9.3 (C), U5.4 (V-); also elsewhere on the board
unnamed: C38.1, D4.3
unnamed: D2.2 (A), Q5.3 (S), Q6.3 (S), R37.2, T1.2 (E)
unnamed: D3.1 (K), Q7.1 (G), R58.2, R59.2, R61.1
unnamed: R29.1, T1.1 (B)
unnamed: R30.1, R33.2, U5.3 (+)
unnamed: R34.1, R36.1, U5.2 (-)
unnamed: R35.1, R38.1, U5.5 (+)
unnamed: R36.2, R44.1, R49.2, U5.1
unnamed: R43.1, R47.1, U5.6 (-)
unnamed: R46.2, T3.2 (E)
unnamed: R47.2, R54.1, U5.7
unnamed: R48.1, R53.2, T3.1 (B)
unnamed: R52.1, R55.1, T4.1 (B)
unnamed: R53.1, T4.3 (C)
unnamed: R57.2, T5.1 (B)
unnamed: R59.1, T5.3 (C)
unnamed: R81.1, R85.1, T7.3 (C)
unnamed: R83.1, T7.1 (B)
unnamed: R85.2, T8.1 (B), T9.1 (B)
VBUS: C35.2, Q7.2 (D), R28.1, R81.2, RV1.1, T8.3 (C); also elsewhere on the board
VREF: R26.1; also elsewhere on the board

Notes on the sheet:
Charge pump
No pull-up/down needed as charge pump not yet running during startup
Low-side PWM switch
If not stated otherwise, all MLCC 50V X7R
PWM voltage
1mA@56V
Load current
PWM current
Negative voltage max: 10V bat - 55V panel = -35V
Comparator for short circuit protection, RC filter still to be tuned
COMP2 using Vref_int = 1.202 ... 1.242 V as reference triggered latest at Vout = 1.242V * (12+8.2)/8.2 = 3.06V
High-side load switch
Optional: PWM switch

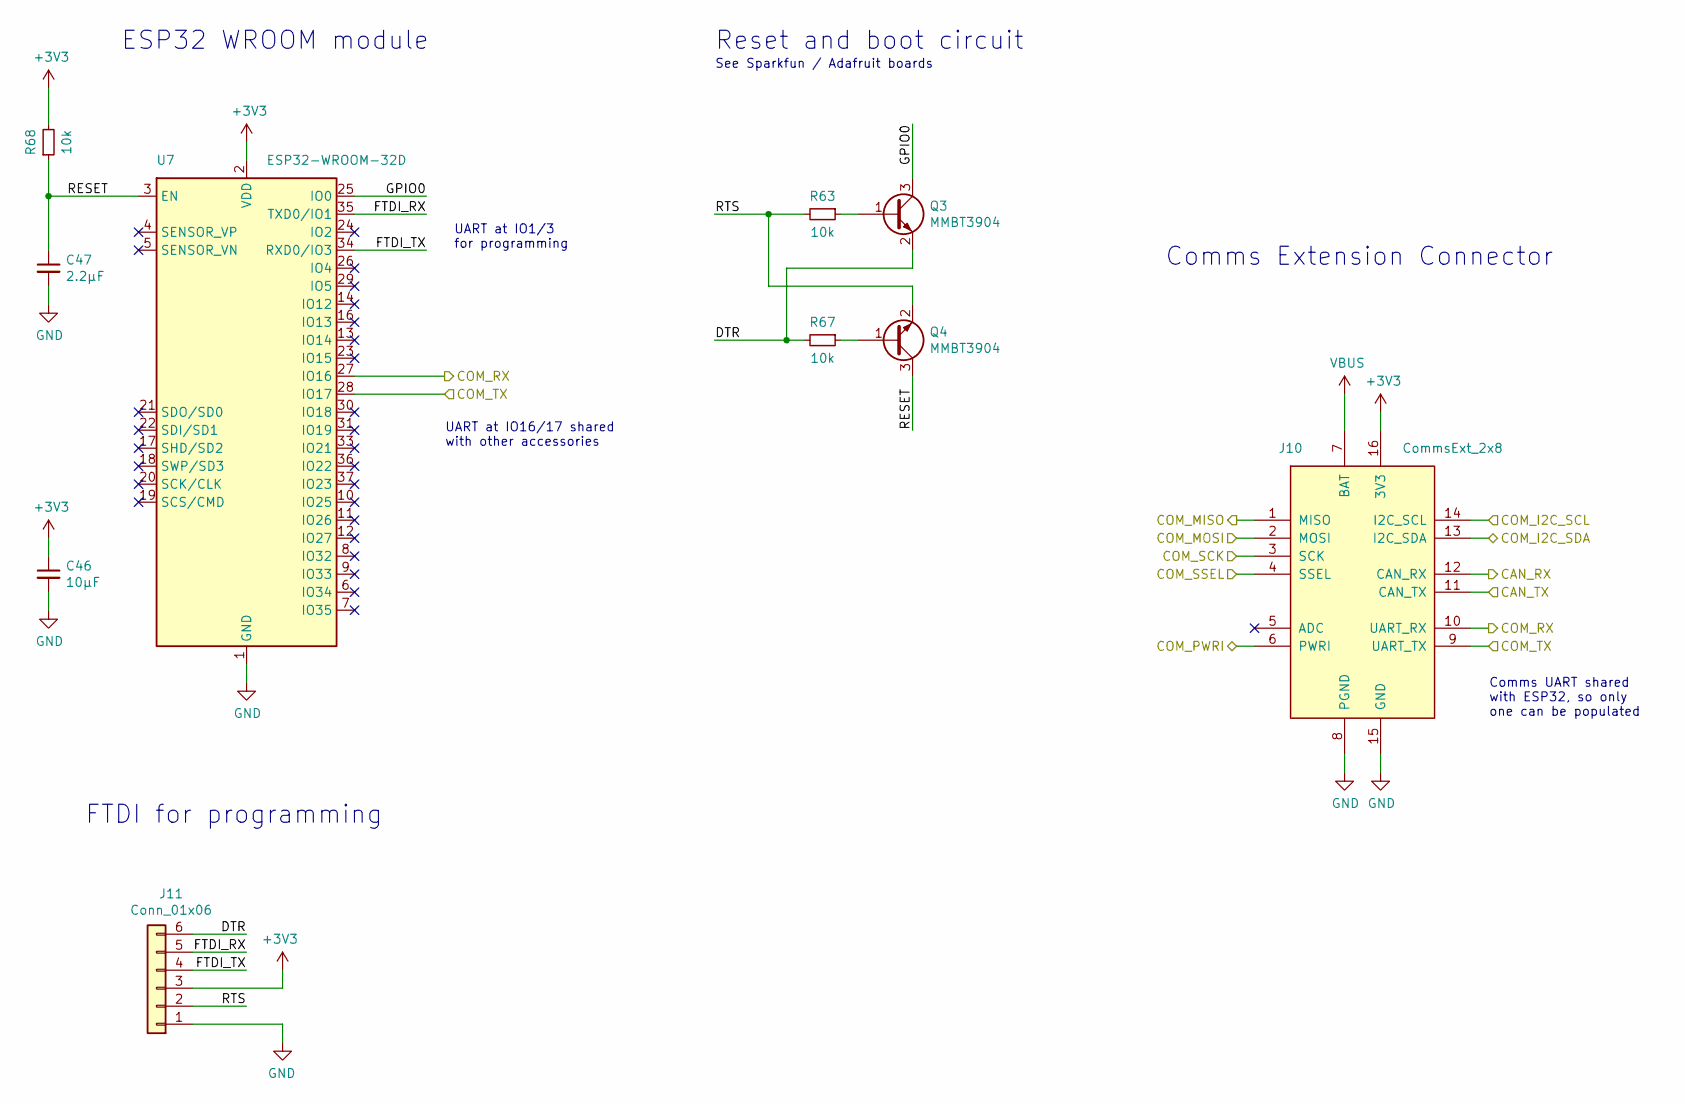
[picture p13: schematic accessories.sch, MPPT 2420 HPX]

Parts:
C46: 10µF; C_0805_2012; PartNumber GRM21BR61C106KE15L
C47: 2.2µF; C_0805_2012
J10: CommsExt_2x8
J11: Conn_01x06; PinHeader_1x06_P2.54mm_Vertical
Q3, Q4: MMBT3904; SOT-23
R63, R67, R68: 10k; R_0603_1608; PartNumber RC0603FR-0710KL
U7: ESP32-WROOM-32D; ESP32-WROOM-32

Connections:
/Accessories/CAN_RX: J10.12 (CAN_RX); also elsewhere on the board
/Accessories/CAN_TX: J10.11 (CAN_TX); also elsewhere on the board
/Accessories/COM_I2C_SCL: J10.14 (I2C_SCL); also elsewhere on the board
/Accessories/COM_I2C_SDA: J10.13 (I2C_SDA); also elsewhere on the board
/Accessories/COM_MISO: J10.1 (MISO); also elsewhere on the board
/Accessories/COM_MOSI: J10.2 (MOSI); also elsewhere on the board
/Accessories/COM_PWRI: J10.6 (PWRI); also elsewhere on the board
/Accessories/COM_RX: J10.10 (UART_RX), U7.27 (IO16); also elsewhere on the board
/Accessories/COM_SCK: J10.3 (SCK); also elsewhere on the board
/Accessories/COM_SSEL: J10.4 (SSEL); also elsewhere on the board
/Accessories/COM_TX: J10.9 (UART_TX), U7.28 (IO17); also elsewhere on the board
/Accessories/DTR: J11.6, Q3.2 (E), R67.2
/Accessories/FTDI_RX: J11.5, U7.35 (TXD0/IO1)
/Accessories/FTDI_TX: J11.4, U7.34 (RXD0/IO3)
/Accessories/GPIO0: Q3.3 (C), U7.25 (IO0)
/Accessories/RESET: C47.1, Q4.3 (C), R68.1, U7.3 (EN)
/Accessories/RTS: J11.2, Q4.2 (E), R63.2
GND: C46.2, C47.2, J10.8 (PGND), J10.15 (GND), J11.1, U7.1 (GND), U7.15 (GND), U7.38 (GND), U7.39 (GND); also elsewhere on the board
unnamed: Q3.1 (B), R63.1
unnamed: Q4.1 (B), R67.1
VBUS: J10.7 (BAT); also elsewhere on the board

Notes on the sheet:
UART at IO1/3 for programming
UART at IO16/17 shared with other accessories
See Sparkfun / Adafruit boards
Reset and boot circuit
FTDI for programming
ESP32 WROOM module
Comms Extension Connector
Comms UART shared with ESP32, so only one can be populated

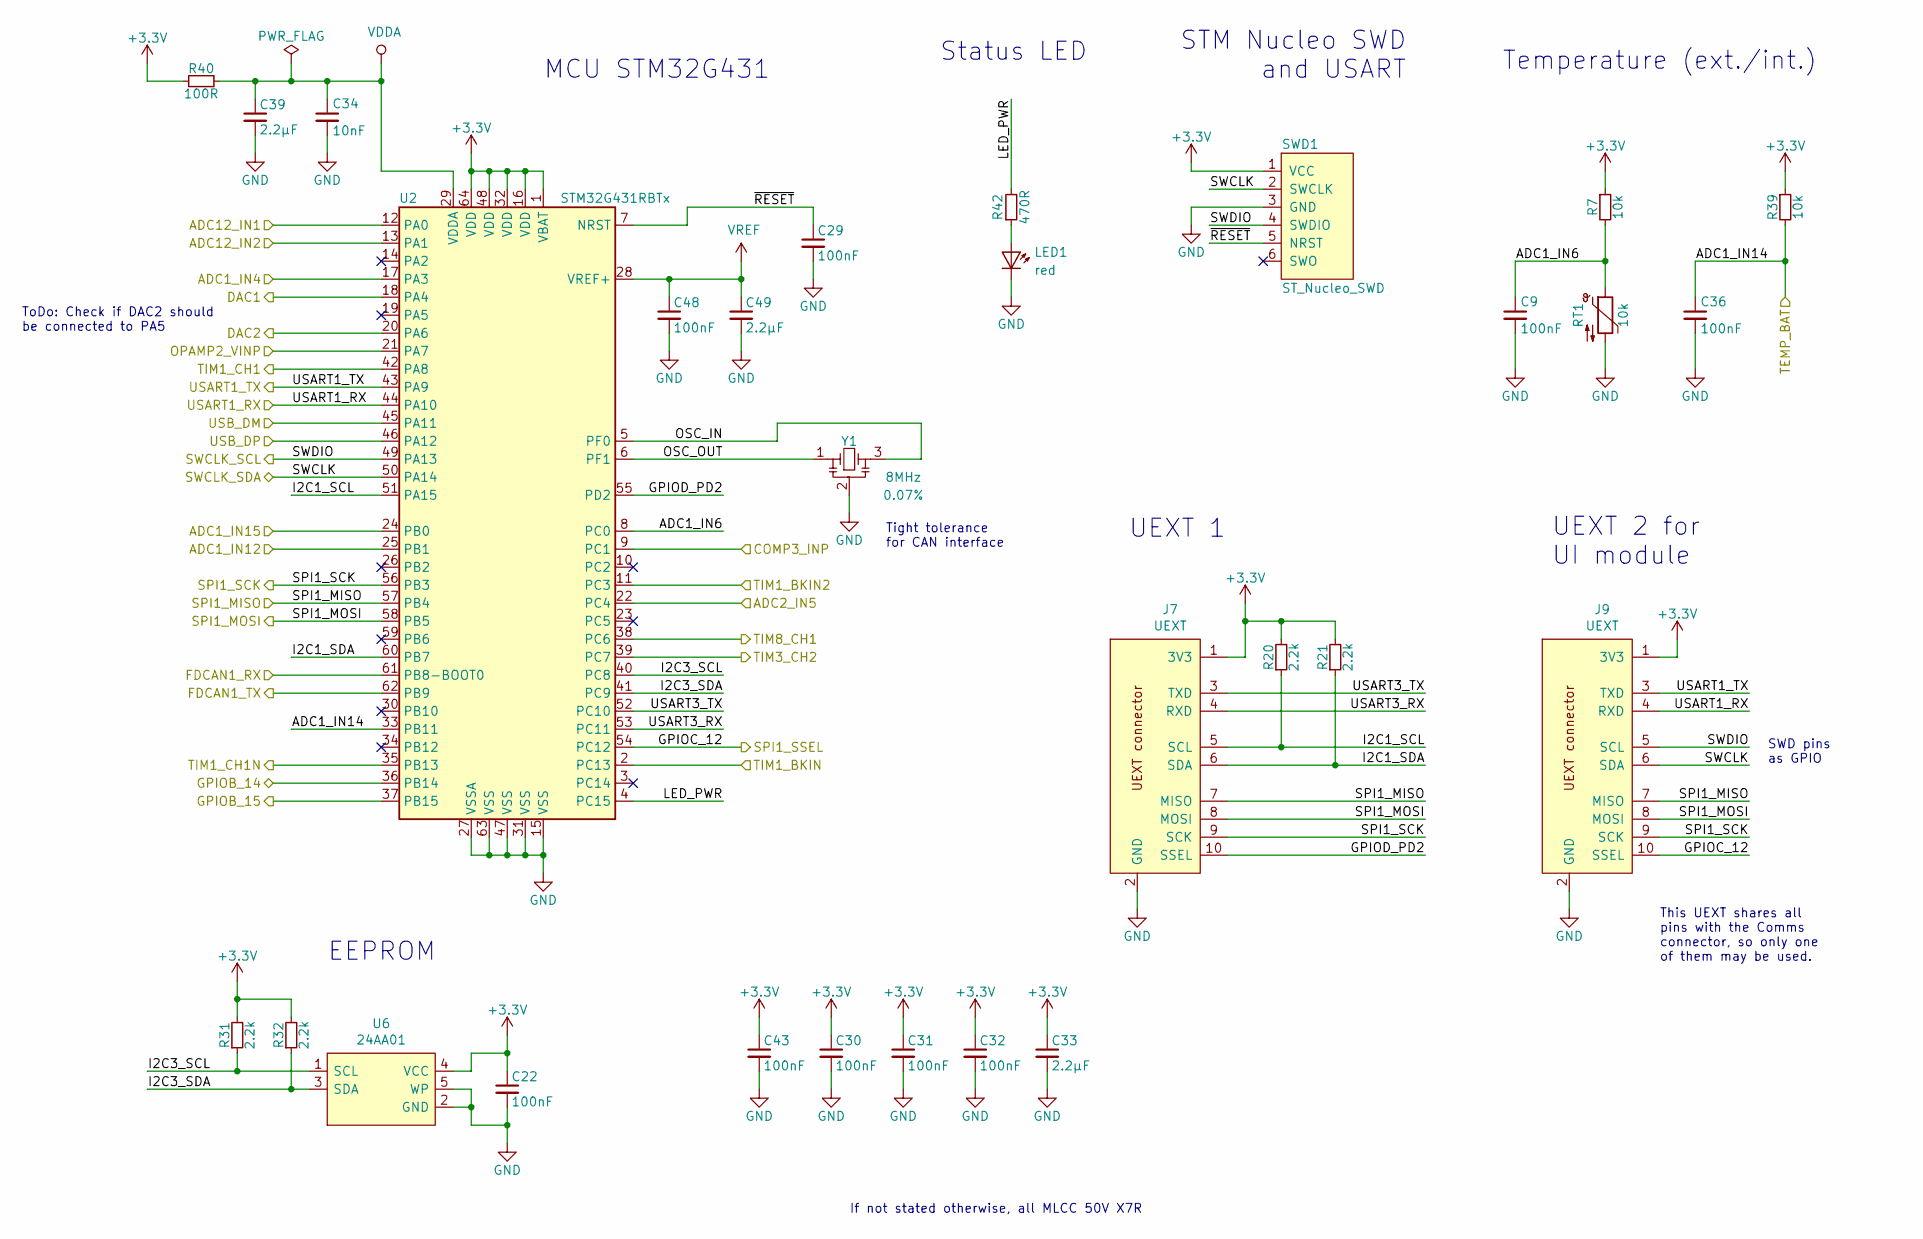
[picture p14: schematic mcu.sch, MPPT 2420 HPX]

Parts:
C9, C22, C29, C30, C31, C32, C36, C43, C48: 100nF; C_0603_1608; PartNumber GRM188R71H104KA93D
C33, C39, C49: 2.2µF; C_0603_1608; PartNumber GRM188R61E225KA12D
C34: 10nF; C_0603_1608
J7, J9: UEXT; Box_Header_2x05x2.54mm_Straight
LED1: red; LED_0603_1608Metric; PartNumber LTST-C190KRKT
R7, R39: 10k; R_0603_1608; PartNumber RC0603FR-0710KL
R20, R21, R31, R32: 2.2k; R_0603_1608; PartNumber RC0603FR-072K2L
R40: 100R; R_0603_1608; PartNumber RC0603FR-07100RL
R42: 470R; R_0603_1608; PartNumber RC0603FR-07470RL
RT1: 10k; R_0603_1608; PartNumber NTCG163JF103FT1S
SWD1: ST_Nucleo_SWD; PinHeader_1x06_P2.54mm_Vertical
U2: STM32G431RBTx; LQFP-64_10x10mm_P0.5mm; PartNumber STM32G431RBT6
U6: 24AA01; SOT-23-5; PartNumber 24AA32AFT-I/OT
Y1: 8MHz; Resonator_Murata_CSTNE; PartNumber CSTNE8M00GH5C000R0

Connections:
/Accessories/CAN_RX: U2.61 (PB8-BOOT0); also elsewhere on the board
/Accessories/CAN_TX: U2.62 (PB9); also elsewhere on the board
/Accessories/COM_I2C_SCL: J9.5 (SCL), SWD1.4 (SWDIO), U2.49 (PA13); also elsewhere on the board
/Accessories/COM_I2C_SDA: J9.6 (SDA), SWD1.2 (SWCLK), U2.50 (PA14); also elsewhere on the board
/Accessories/COM_MISO: J7.7 (MISO), J9.7 (MISO), U2.57 (PB4); also elsewhere on the board
/Accessories/COM_MOSI: J7.8 (MOSI), J9.8 (MOSI), U2.58 (PB5); also elsewhere on the board
/Accessories/COM_PWRI: U2.36 (PB14); also elsewhere on the board
/Accessories/COM_RX: J9.4 (RXD), U2.44 (PA10); also elsewhere on the board
/Accessories/COM_SCK: J7.9 (SCK), J9.9 (SCK), U2.56 (PB3); also elsewhere on the board
/Accessories/COM_SSEL: J9.10 (SSEL), U2.54 (PC12); also elsewhere on the board
/Accessories/COM_TX: J9.3 (TXD), U2.43 (PA9); also elsewhere on the board
/DC/DC/NOC_ALERT: U2.11 (PC3); also elsewhere on the board
/DC/DC/POC_ALERT: U2.2 (PC13); also elsewhere on the board
/DC/DC/PWM_HS: U2.42 (PA8); also elsewhere on the board
/DC/DC/PWM_LS: U2.35 (PB13); also elsewhere on the board
/LOAD-: U2.21 (PA7); also elsewhere on the board
/LV switches/CP_PWM: U2.38 (PC6); also elsewhere on the board
/LV switches/PWM_SW_EN: U2.39 (PC7); also elsewhere on the board
/MCU/ADC1_IN4: U2.17 (PA3); also elsewhere on the board
/MCU/ADC1_IN6: C9.1, R7.2, RT1.1, U2.8 (PC0)
/MCU/ADC1_IN12: U2.25 (PB1); also elsewhere on the board
/MCU/ADC1_IN15: U2.24 (PB0); also elsewhere on the board
/MCU/ADC2_IN5: U2.22 (PC4); also elsewhere on the board
/MCU/ADC12_IN1: U2.12 (PA0); also elsewhere on the board
/MCU/ADC12_IN2: U2.13 (PA1); also elsewhere on the board
/MCU/COMP3_INP: U2.9 (PC1); also elsewhere on the board
/MCU/DAC1: U2.18 (PA4); also elsewhere on the board
/MCU/DAC2: U2.20 (PA6); also elsewhere on the board
/MCU/GPIOB_15: U2.37 (PB15); also elsewhere on the board
/MCU/GPIOD_PD2: J7.10 (SSEL), U2.55 (PD2)
/MCU/I2C1_SCL: J7.5 (SCL), R20.1, U2.51 (PA15)
/MCU/I2C1_SDA: J7.6 (SDA), R21.1, U2.60 (PB7)
/MCU/I2C3_SCL: R31.1, U2.40 (PC8), U6.1 (SCL)
/MCU/I2C3_SDA: R32.1, U2.41 (PC9), U6.3 (SDA)
/MCU/LED_PWR: R42.2, U2.4 (PC15)
/MCU/OSC_IN: U2.5 (PF0), Y1.3
/MCU/OSC_OUT: U2.6 (PF1), Y1.1
/MCU/TEMP_BAT: C36.1, R39.2, U2.33 (PB11); also elsewhere on the board
/MCU/USART3_RX: J7.4 (RXD), U2.53 (PC11)
/MCU/USART3_TX: J7.3 (TXD), U2.52 (PC10)
/MCU/USB_DM: U2.45 (PA11); also elsewhere on the board
/MCU/USB_DP: U2.46 (PA12); also elsewhere on the board
/MCU/~RESET: C29.1, SWD1.5 (NRST), U2.7 (NRST)
GND: C9.2, C22.2, C29.2, C30.2, C31.2, C32.2, C33.2, C34.2, C36.2, C39.2, C43.2, C48.2, C49.2, J7.2 (GND), J9.2 (GND), LED1.1 (K), RT1.2, SWD1.3 (GND), U2.15 (VSS), U2.27 (VSSA), U2.31 (VSS), U2.47 (VSS), U2.63 (VSS), U6.2 (GND), U6.5 (WP), Y1.2; also elsewhere on the board
unnamed: LED1.2 (A), R42.1
VDDA: C34.1, C39.1, R40.1, U2.29 (VDDA)
VREF: C48.1, C49.1, U2.28 (VREF+); also elsewhere on the board

Notes on the sheet:
Status LED
MCU STM32G431
STM Nucleo SWD and USART
Tight tolerance for CAN interface
EEPROM
If not stated otherwise, all MLCC 50V X7R
Temperature (ext./int.)
ToDo: Check if DAC2 should be connected to PA5
SWD pins as GPIO
UEXT 2 for UI module
UEXT 1
This UEXT shares all pins with the Comms connector, so only one of them may be used.

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
