LibreSolar/mppt-2420-hpx/kicad/mppt-2420-hpx.kicad_pcb

## KiCad design kicad/mppt-2420-hpx.kicad_pcb (continued)

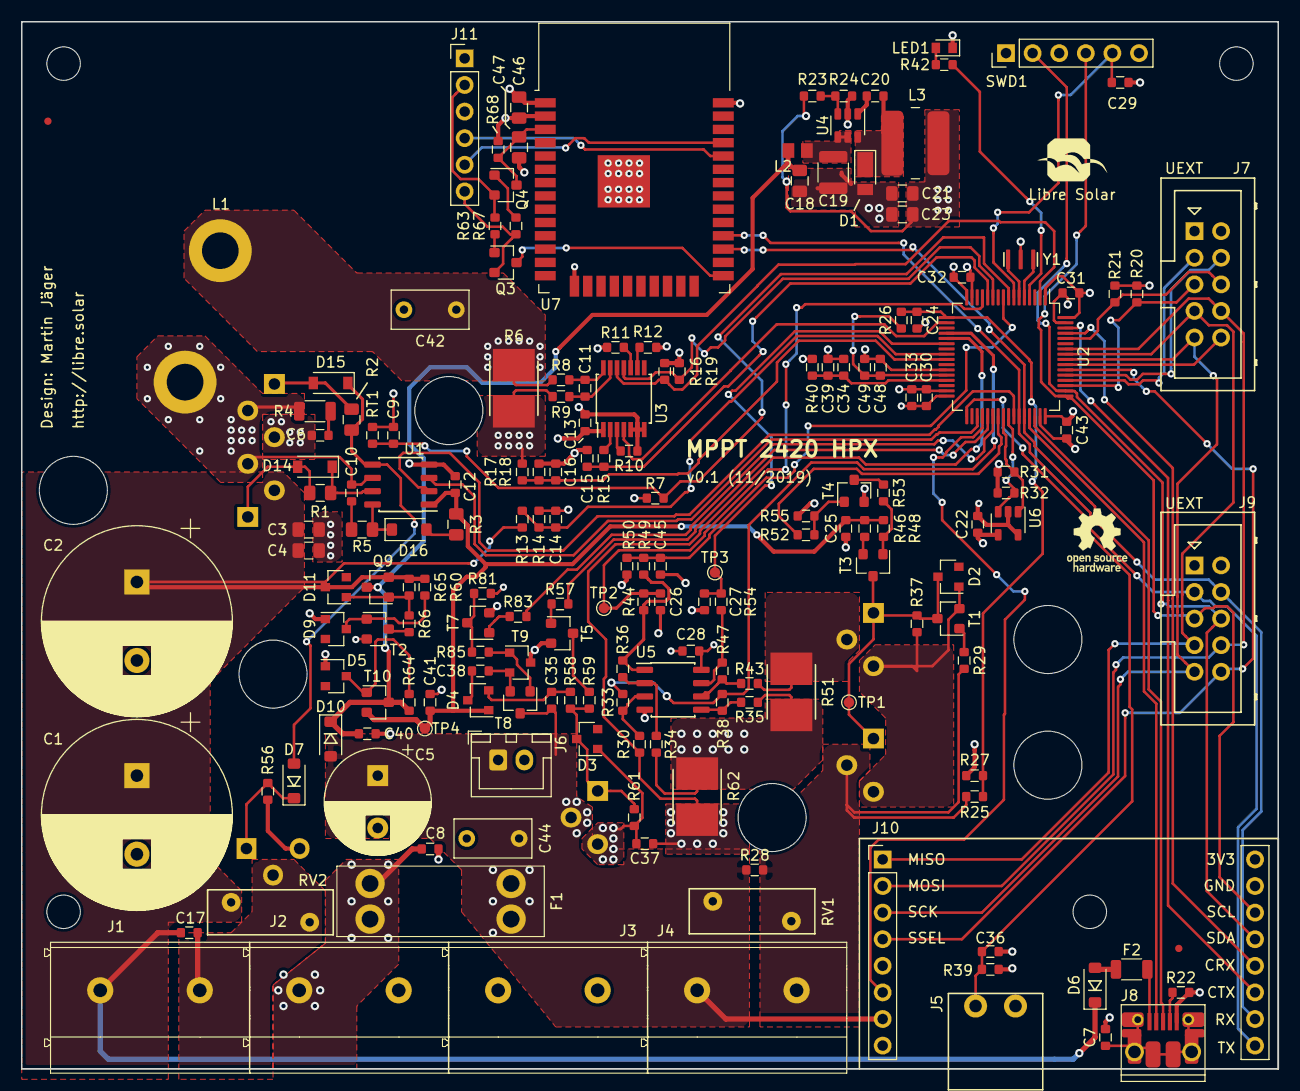
[picture p15: board mppt-2420-hpx.kicad_pcb from above]

Board: 4 copper layers, 120.0 x 100.0 mm, 191 parts (0 on the bottom side), 116 nets.

Other parts of the board:
TEST: TestPoint_Pad_1.0x1.0mm
